adafruit/Adafruit-Feather-RP2040-ThinkInk/factory-reset/README.md

## Factory Reset file - Feather RP2040 ThinkInk with 24-pin E-Paper Display - STEMMA QT

This is the factory reset file for the Feather RP2040 ThinkInk with 24-pin E-Paper Display - STEMMA QT.
