adafruit/Adafruit-Feather-RP2040-ThinkInk/Adafruit Feather RP2040 ThinkInk PrettyPins 2.pdf

# Adafruit Feather RP2040 ThinkInk

# https://www.adafruit.com/product/5727

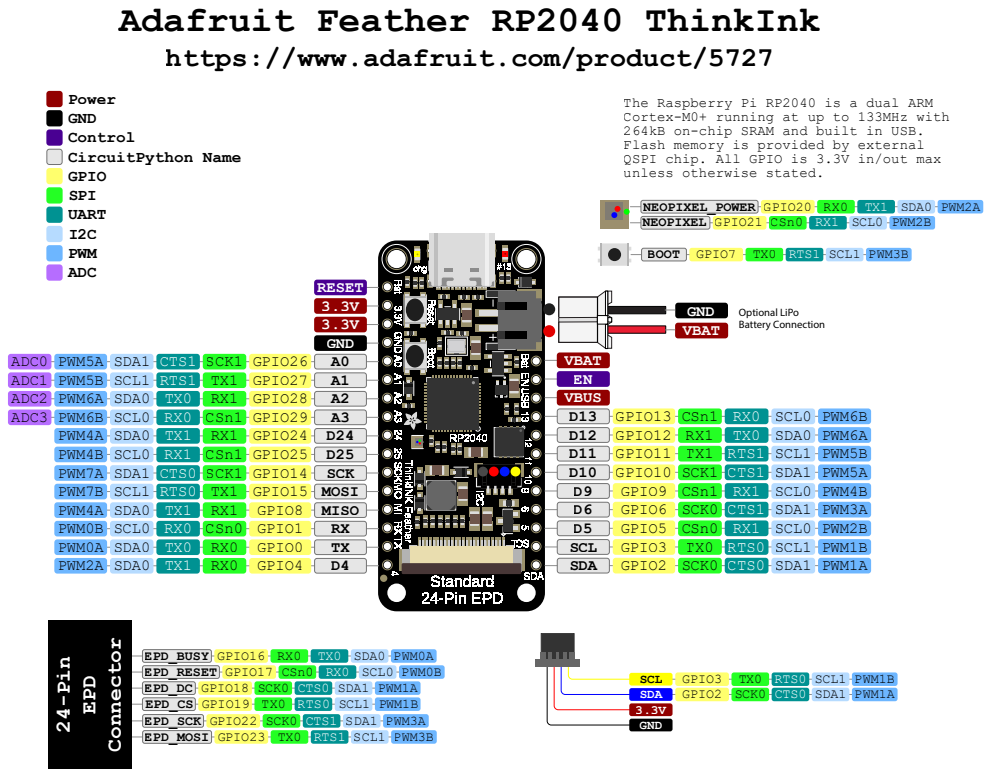
[picture p2: page 1]

The Raspberry Pi RP2040 is a dual ARM
Cortex-M0+ running at up to 133MHz with
264kB on-chip SRAM and built in USB.
Flash memory is provided by external
QSPI chip. All GPIO is 3.3V in/out max
unless otherwise stated.
NEOPIXEL_POWER GPIO20 RX0 TX1 SDA0 PWM2A
NEOPIXEL GPIO21 CSn0 RX1 SCL0 PWM2B
BOOT GPIO7 TX0 RTS1 SCL1 PWM3B
GND
VBAT
