adafruit/Adafruit-Feather-RP2040-ThinkInk/Adafruit Feather RP2040 ThinkInk.brd

## EAGLE design Adafruit Feather RP2040 ThinkInk.brd (2023-05-01)

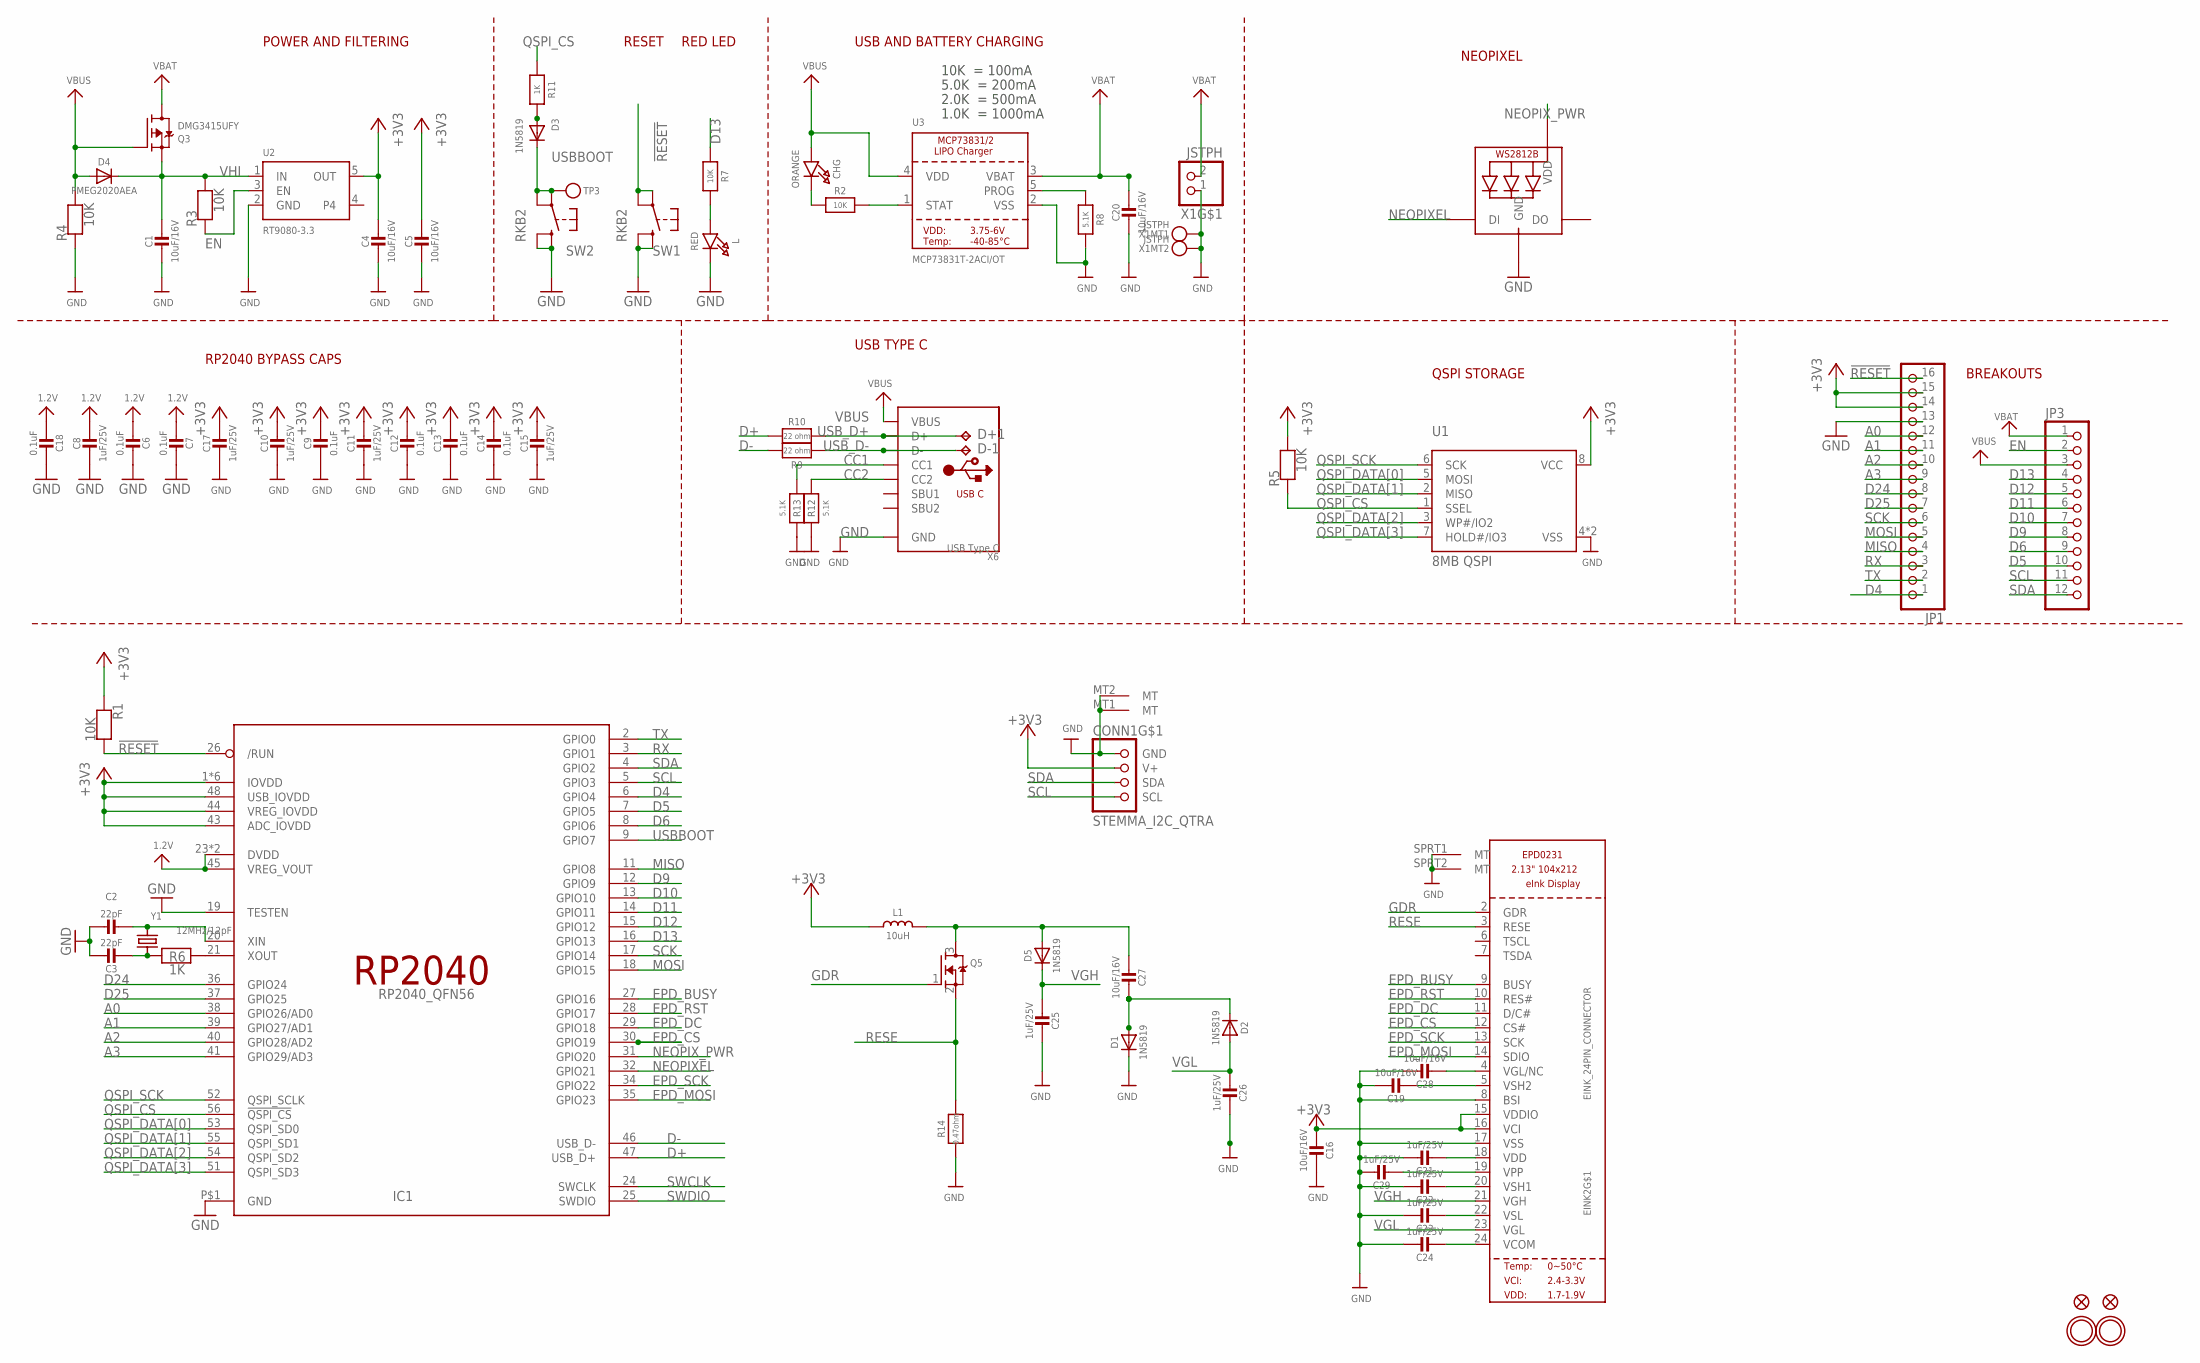
[picture p3: schematic Adafruit Feather RP2040 ThinkInk.sch]

Parts:
C1, C4, C5, C16, C19, C20, C27, C28: 10uF/16V; 0805-NO
C2, C3: 22pF; _0402NO
C6, C7, C9, C12, C13, C14, C18: 0.1uF; _0402NO
C8, C10, C11, C15, C17, C21, C22, C23, C24, C25, C26, C29: 1uF/25V; _0402NO
CHG: ORANGE; CHIPLED_0603_NOOUTLINE
CONN1: STEMMA_I2C_QTRA; JST_SH4_RA
D1, D2, D3, D5: 1N5819; SOD-323_MINI
D4: PMEG2020AEA; SOD-323F
D+1: TPB1,27; B1,27
D-1: TPB1,27; B1,27
EINK2: EINK_24PIN_CONNECTOR; EINK_24PIN
IC1: RP2040_QFN56; QFN56_7MM_REDUCEDEPAD
JP1: HEADER-1X16ROUND; 1X16_ROUND
JP3: HEADER-1X12; 1X12_ROUND
L: RED; CHIPLED_0603_NOOUTLINE
L1: 10uH; INDUCTOR_4X4MM_NR401
LED1: WS2812B_SK6805_1515; SK6805_1515
Q3: DMG3415UFY; DFN2015-3
Q5: IRLML0100; SOT23-WIDE
R1, R2, R3, R4, R5, R7: 10K; _0402NO
R6, R11: 1K; _0402NO
R8, R12, R13: 5.1K; _0402NO
R9, R10: 22 ohm; _0402NO
R14: 0.47ohm; 0603-NO
SW1, SW2: RKB2; BTN_RKB2_4.6X2.8
TP3: TESTPOINTROUND1.5MMNO; TESTPOINT_ROUND_1.5MM_NO
U1: 8MB QSPI; USON8_4X4
U2: RT9080-3.3; SOT23-5; JLC_ROTATION 0
U3: MCP73831T-2ACI/OT; SOT23-5
U$31, U$32: MOUNTINGHOLE2.5; MOUNTINGHOLE_2.5_PLATED
U$34, U$35: FIDUCIAL_1MM
X1: JSTPH; JSTPH2_BATT
X6: USB Type C; USB_C_CUSB31-CFM2AX-01-X
Y1: 12MHz/12pF; CRYSTAL_2.5X2

Connections:
1.2V: C6.2, C7.2, C8.1, C18.2, IC1.23 (DVDD), IC1.45 (VREG_VOUT), IC1.50 (DVDD)
!RESET: IC1.26 (/RUN), JP1.16, R1.2, SW1.A, SW1.A' (P1)
+3V3: C4.1, C5.1, C9.1, C10.1, C11.1, C12.1, C13.1, C14.1, C15.1, C16.2, C17.1, CONN1.2 (V+), EINK2.15 (VDDIO), EINK2.16 (VCI), IC1.1 (IOVDD), IC1.10 (IOVDD), IC1.22 (IOVDD), IC1.33 (IOVDD), IC1.42 (IOVDD), IC1.43 (ADC_IOVDD), IC1.44 (VREG_IOVDD), IC1.48 (USB_IOVDD), IC1.49 (IOVDD), JP1.14, JP1.15, L1.P$2 (2), R1.1, R5.2, U1.8 (VCC), U2.5 (OUT)
A0: IC1.38 (GPIO26/AD0), JP1.12
A1: IC1.39 (GPIO27/AD1), JP1.11
A2: IC1.40 (GPIO28/AD2), JP1.10
A3: IC1.41 (GPIO29/AD3), JP1.9
CC1: R13.2, X6.A5 (CC1)
CC2: R12.2, X6.B5 (CC2)
D4: IC1.6 (GPIO4), JP1.1
D5: IC1.7 (GPIO5), JP3.10
D6: IC1.8 (GPIO6), JP3.9
D9: IC1.12 (GPIO9), JP3.8
D10: IC1.13 (GPIO10), JP3.7
D11: IC1.14 (GPIO11), JP3.6
D12: IC1.15 (GPIO12), JP3.5
D13: IC1.16 (GPIO13), JP3.4, R7.1
D24: IC1.36 (GPIO24), JP1.8
D25: IC1.37 (GPIO25), JP1.7
D+: IC1.47 (USB_D+), R10.2
D-: IC1.46 (USB_D-), R9.2
EN: JP3.2, R3.1, U2.3 (EN)
EPD_BUSY: EINK2.9 (BUSY), IC1.27 (GPIO16)
EPD_CS: EINK2.12 (CS#), IC1.30 (GPIO19)
EPD_DC: EINK2.11 (D/C#), IC1.29 (GPIO18)
EPD_MOSI: EINK2.14 (SDIO), IC1.35 (GPIO23)
EPD_RST: EINK2.10 (RES#), IC1.28 (GPIO17)
EPD_SCK: EINK2.13 (SCK), IC1.34 (GPIO22)
GDR: EINK2.2 (GDR), Q5.1 (G)
GND: C1.2, C2.1, C3.1, C4.2, C5.2, C6.1, C7.1, C8.2, C9.2, C10.2, C11.2, C12.2, C13.2, C14.2, C15.2, C16.1, C17.2, C18.1, C19.1, C20.2, C21.1, C22.1, C23.1, C24.1, C25.2, C26.2, C28.1, C29.1, CONN1.1 (GND), CONN1.MT1 (MT), CONN1.MT2 (MT), D1.C, EINK2.8 (BSI), EINK2.17 (VSS), EINK2.SPRT1 (MT), EINK2.SPRT2 (MT), IC1.19 (TESTEN), IC1.P$1 (GND), JP1.13, L.C, LED1.4 (GND), R4.1, R8.2, R12.1, R13.1, R14.2, SW1.B (S), SW1.B' (S1), SW2.B (S), SW2.B' (S1), U1.4 (VSS), U1.PAD (VSS), U2.2 (GND), U3.2 (VSS), X1.1, X1.NC1, X1.NC2, X6.A1B12 (GND), X6.B1A12 (GND)
MISO: IC1.11 (GPIO8), JP1.4
MOSI: IC1.18 (GPIO15), JP1.5
unnamed: CHG.C, R2.1
unnamed: L.A, R7.2
unnamed: R2.2, U3.1 (STAT)
unnamed: R8.1, U3.5 (PROG)
unnamed: C2.2, IC1.20 (XIN), Y1.3 (2)
unnamed: C3.2, R6.1, Y1.1
unnamed: IC1.21 (XOUT), R6.2
unnamed: C19.2, EINK2.5 (VSH2)
unnamed: C21.2, EINK2.18 (VDD)
unnamed: C22.2, EINK2.20 (VSH1)
unnamed: C27.2, D1.A, D2.C
unnamed: C27.1, D5.A, L1.P$1 (1), Q5.3 (D)
unnamed: C28.2, EINK2.4 (VGL/NC)
unnamed: C29.2, EINK2.19 (VPP)
unnamed: D3.A, R11.2
unnamed: C23.2, EINK2.22 (VSL)
unnamed: C24.2, EINK2.24 (VCOM)
NEOPIXEL: IC1.32 (GPIO21), LED1.1 (DI)
NEOPIX_PWR: IC1.31 (GPIO20), LED1.2 (VDD)
QSPI_CS: IC1.56 (!QSPI_CS), R5.1, R11.1, U1.1 (SSEL)
QSPI_DATA[0]: IC1.53 (QSPI_SD0), U1.5 (MOSI)
QSPI_DATA[1]: IC1.55 (QSPI_SD1), U1.2 (MISO)
QSPI_DATA[2]: IC1.54 (QSPI_SD2), U1.3 (WP#/IO2)
QSPI_DATA[3]: IC1.51 (QSPI_SD3), U1.7 (HOLD#/IO3)
QSPI_SCK: IC1.52 (QSPI_SCLK), U1.6 (SCK)
RESE: EINK2.3 (RESE), Q5.2 (S), R14.1
RX: IC1.3 (GPIO1), JP1.3
SCK: IC1.17 (GPIO14), JP1.6
SCL: CONN1.4 (SCL), IC1.5 (GPIO3), JP3.11
SDA: CONN1.3 (SDA), IC1.4 (GPIO2), JP3.12
SWCLK: IC1.24 (SWCLK)
SWDIO: IC1.25 (SWDIO)
TX: IC1.2 (GPIO0), JP1.2
USBBOOT: D3.C, IC1.9 (GPIO7), SW2.A, SW2.A' (P1), TP3.P$1
USB_D+: D+1.TP, R10.1, X6.A6 (D+), X6.B6 (D+)
USB_D-: D-1.TP, R9.1, X6.A7 (D-), X6.B7 (D-)
VBAT: C20.1, JP3.1, Q3.3 (D), U3.3 (VBAT), X1.2
VBUS: CHG.A, D4.A, JP3.3, Q3.1 (G), R4.2, U3.4 (VDD), X6.A4B9 (VBUS), X6.B4A9 (VBUS)
VGH: C25.1, D5.C, EINK2.21 (VGH)
VGL: C26.1, D2.A, EINK2.23 (VGL)
VHI: C1.1, D4.C, Q3.2 (S), R3.2, U2.1 (IN)

Notes on the sheet:
POWER AND FILTERING
RESET
10K = 100mA
5.0K = 200mA
2.0K = 500mA
1.0K = 1000mA
USB AND BATTERY CHARGING
BREAKOUTS
RED LED
RP2040 BYPASS CAPS
USB TYPE C
QSPI STORAGE
NEOPIXEL

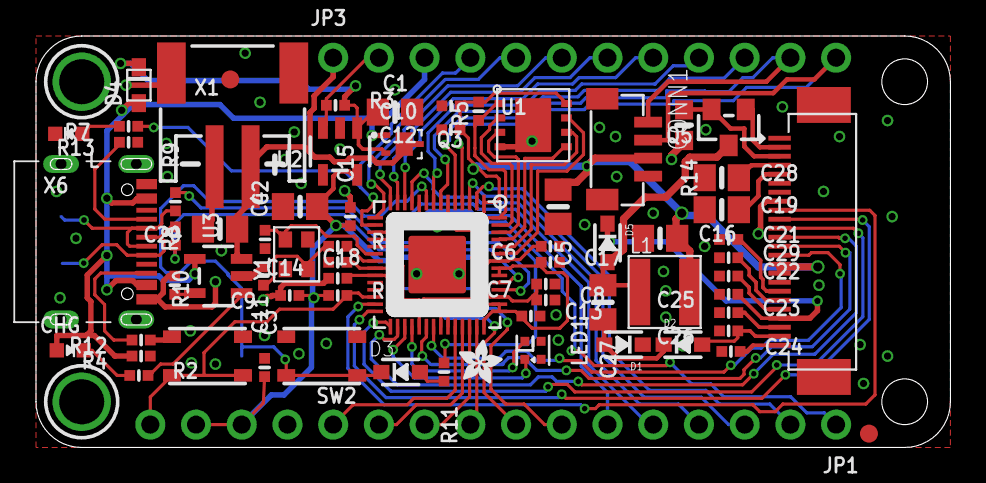
[picture p4: board Adafruit Feather RP2040 ThinkInk.brd from above]

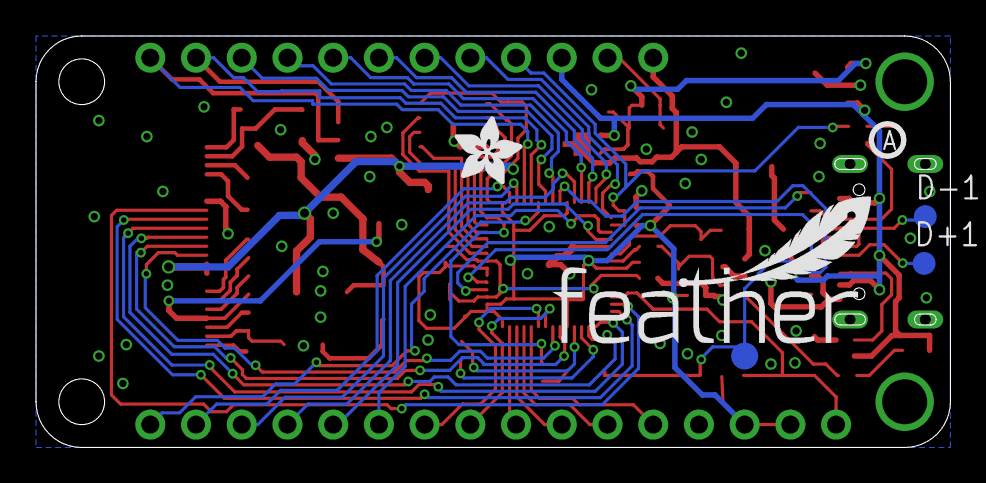
[picture p5: board Adafruit Feather RP2040 ThinkInk.brd from below]

Board: 2 copper layers, 50.8 x 22.9 mm, 145 parts (38 on the bottom side), 71 nets.

Other parts of the board:
PLABEL0: PLABEL0
PLABEL1: PLABEL1
PLABEL2: PLABEL2
PLABEL3: PLABEL3
PLABEL4: PLABEL4
PLABEL5: PLABEL5
PLABEL6: PLABEL6
PLABEL7: PLABEL7
PLABEL8: PLABEL8
PLABEL9: PLABEL9
PLABEL10: PLABEL10
PLABEL11: PLABEL11
PLABEL12: PLABEL12
PLABEL13: PLABEL13
PLABEL14: PLABEL14
PLABEL15: PLABEL15
PLABEL16: PLABEL16
PLABEL17: PLABEL17
PLABEL18: PLABEL18
PLABEL19: PLABEL19
PLABEL20: PLABEL20
PLABEL21: PLABEL21
PLABEL22: PLABEL22
PLABEL23: PLABEL23
PLABEL24: PLABEL24
PLABEL25: PLABEL25
PLABEL26: PLABEL26
PLABEL27: PLABEL27
PLABEL28: PLABEL28
PLABEL29: PLABEL29
PLABEL30: PLABEL30
PLABEL31: PLABEL31
PLABEL32: PLABEL32
PLABEL33: PLABEL33
PLABEL34: PLABEL34
PLABEL35: PLABEL35
PLABEL36: PLABEL36
PLABEL37: PLABEL37
PLABEL38: PLABEL38
PLABEL39: PLABEL39
PLABEL40: PLABEL40
PLABEL41: PLABEL41
PLABEL42: PLABEL42
PLABEL43: PLABEL43
PLABEL44: PLABEL44
PLABEL45: PLABEL45
PLABEL46: PLABEL46
PLABEL47: PLABEL47
PLABEL48: PLABEL48
PLABEL49: PLABEL49
PLABEL50: PLABEL50
PLABEL51: PLABEL51
PLABEL52: PLABEL52
PLABEL53: PLABEL53
PLABEL54: PLABEL54
PLABEL55: PLABEL55
PLABEL56: PLABEL56
PLABEL57: PLABEL57
PLABEL58: PLABEL58
PLABEL59: PLABEL59
PLABEL60: PLABEL60
PLABEL61: PLABEL61
PLABEL62: PLABEL62
PLABEL63: PLABEL63
PLABEL64: PLABEL64
PLABEL65: PLABEL65
PLABEL66: PLABEL66
U$13: PCBFEAT-REV-040
U$28: ADAFRUIT_2.5MM
U$42: ADAFRUIT_3.5MM
U$46: FEATHERLOGO_MED
