adafruit/Adafruit-Feather-RP2040-ThinkInk/(commit log)

2023-05-01 Adding cookiecutter output
    [Adafruit Feather RP2040 ThinkInk.brd, Adafruit Feather RP2040 ThinkInk.sch]
2025-09-24 Update battery connector image
